calbasantana/walking-bot/STLs/right_servo_leg_part_2_x2.stl

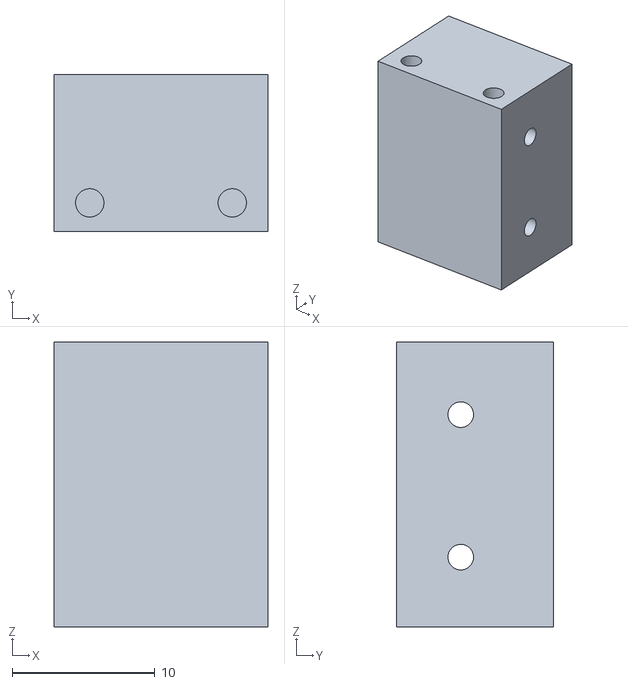
[picture p14: CAD file, 2025-06-26]
STLs/right_servo_leg_part_2_x2.stl
15.0 x 11.0 x 20.0
