calbasantana/walking-bot/STLs/base.stl

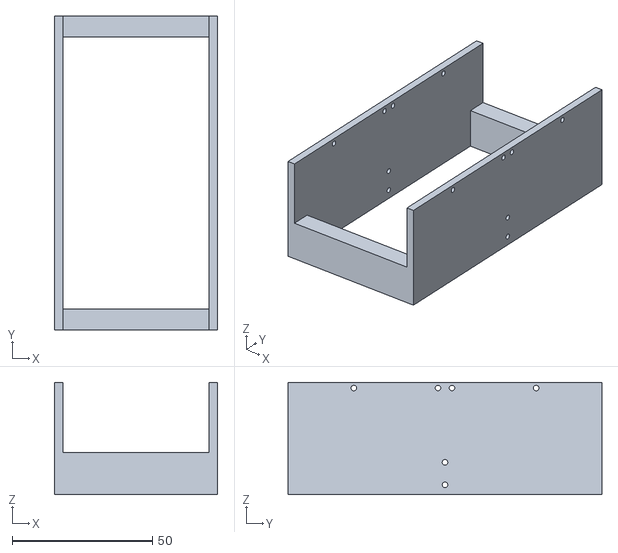
[picture p15: CAD file, 2025-06-26]
STLs/base.stl
58.2 x 112.0 x 40.0
