calbasantana/walking-bot/STLs/pcb_holder.stl

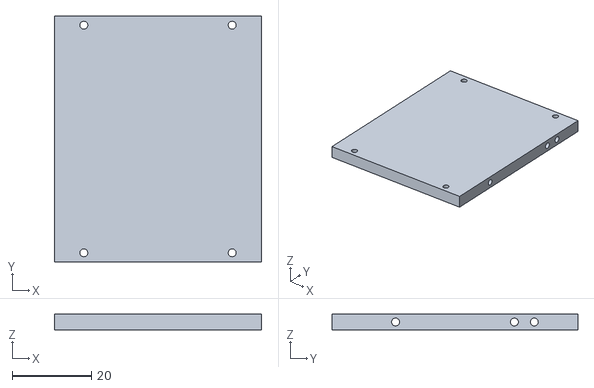
[picture p16: CAD file, 2025-06-26]
STLs/pcb_holder.stl
52.2 x 62.0 x 4.00
