calbasantana/walking-bot/STLs/right_servo_foot_x2.stl

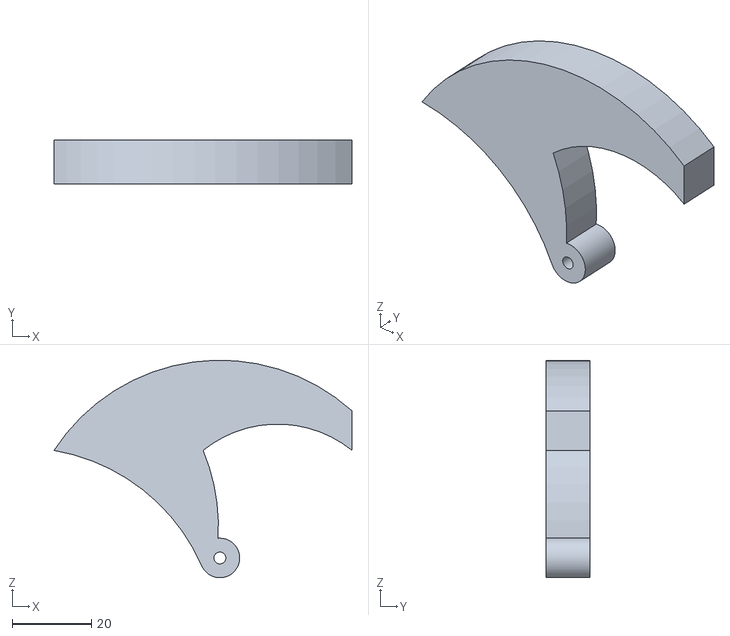
[picture p17: CAD file, 2025-06-26]
STLs/right_servo_foot_x2.stl
75.4 x 11.0 x 55.0
