calbasantana/walking-bot/STLs/right_servo_leg_part_1_x2.stl

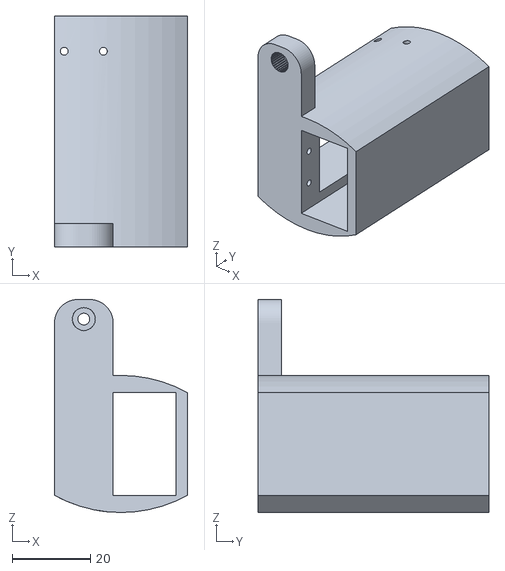
[picture p18: CAD file, 2025-06-26]
STLs/right_servo_leg_part_1_x2.stl
34.0 x 59.0 x 54.4
