calbasantana/walking-bot/STLs/motor_mount.stl

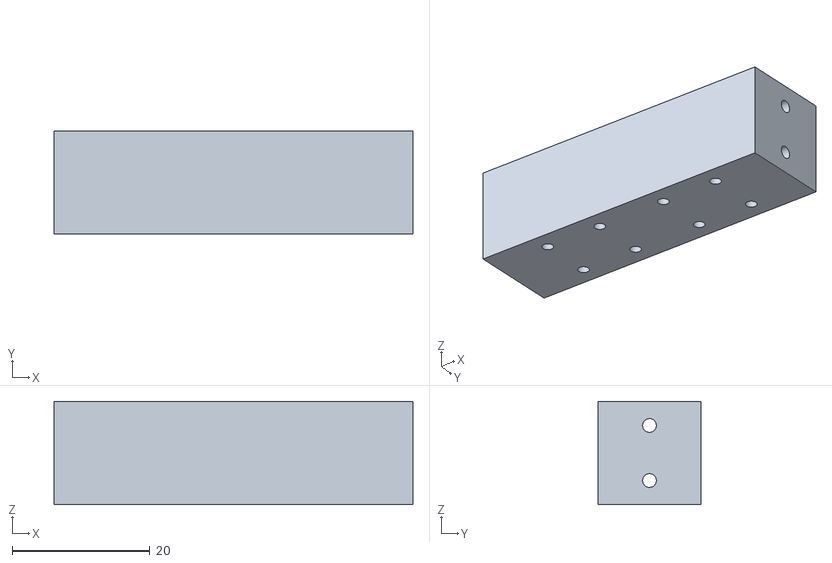
[picture p19: CAD file, 2025-06-26]
STLs/motor_mount.stl
52.2 x 15.0 x 15.0
