calbasantana/walking-bot/STLs/battery_holder.stl

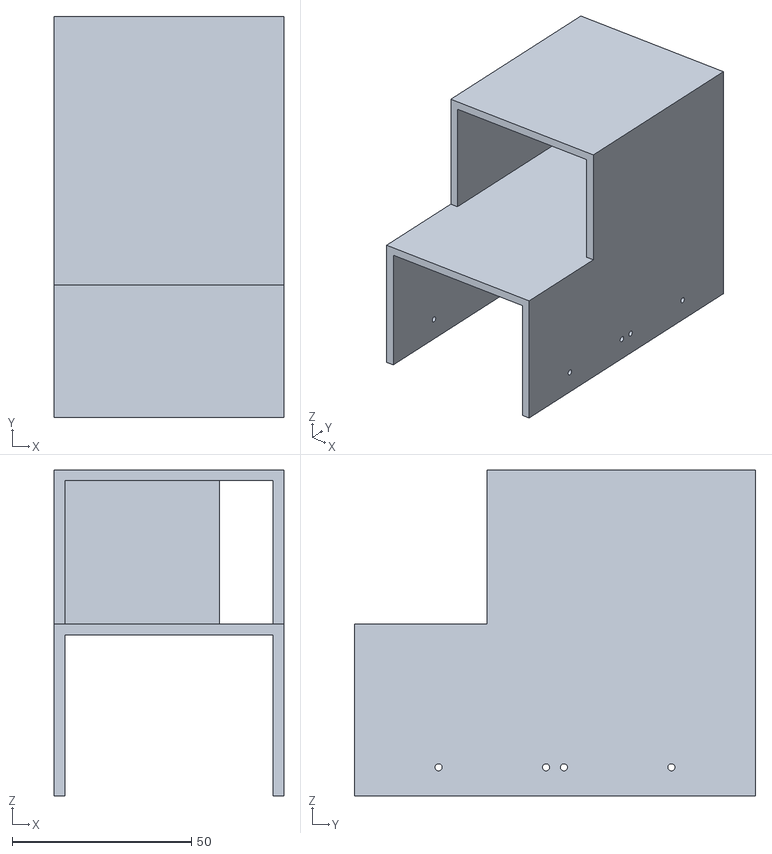
[picture p20: CAD file, 2025-06-26]
STLs/battery_holder.stl
64.2 x 112.0 x 91.0
