calbasantana/walking-bot/(list of files, cad)

Other CAD files:
STLs/left_servo_foot_part_2_x2.stl
STLs/left_servo_leg_part_1_x2.stl
STLs/left_servo_foot_x2.stl
